ostrzak/mrna-toy/docs/images/toy-concept.prompt.txt

Use case: sketch-to-render.
Asset type: a new current-V3 concept illustration for a wearable mechanical mRNA translation toy's project documentation.
Input image: the supplied FreeCAD screenshot is the CURRENT structural reference. Transform this engineering screenshot into a polished, believable industrial-design product concept render. Preserve its component relationships; refine lighting, surface finish and presentation. This is concept art, not a manufacturing drawing.
Scene and composition: one complete unworn bracelet, three-quarter product view on a warm light-grey studio surface, soft contact shadow, landscape composition. Show the entire cuff, its opening, both ribosome lobes and the entire emerging protein strand, large and readable. No people, inset panels or extra products.
Architecture to preserve: a substantial matte navy plastic C-shaped cuff, about 60 mm internal diameter and 20 mm wide, with a continuous palmar arc and its opening close to the ribosome on the upper side, as in the screenshot. A separate much narrower teal RNA-like C dial slides in a shallow track along the cuff edge; it has small rounded mint, amber and lilac nucleotide crossbars. Make the distinction between structural cuff and thin moving RNA dial unmistakable. In this partly played pose the RNA arc can cross part of the cuff opening. Keep the structural cuff itself visibly open. The ribosome is fixed on ONE end of the cuff: organic asymmetric lavender upper and deeper-purple lower lobes, with a neat seam for the upper lobe to swivel. It does not rigidly connect the two cuff ends.
Protein: one short open chain of small simple coral/peach rounded bead placeholders on a fine concealed poseable core exits directly from one low side port beside the ribosome, roughly tangent to the RNA path. Show about 12–18 beads in one relaxed partial folded curve away from the cuff, with one free terminal end. Keep beads round, consistent in size and spacing, as in current CAD; their more molecular redesign is future work. All waiting beads are hidden INSIDE the thick cuff. No visible incoming chain, no bead loop around the wrist, no second exposed end, no tight protein turn around the swivel, no wire sticking out of the free end.
Finish and style: attractive restrained product visualization, finely satin plastic, soft studio light, realistic highlights, rounded edges, clean readable silhouette. Retain navy/teal, lavender and coral colours as provisional design colours. Avoid visual clutter and an oversized perfect circular halo.
Avoid: flexible fabric or silicone straps, buckles, elastic bands, closed solid bracelet replacing the C cuff, exposed conventional rack teeth, DNA double helices, motors, screens, jewellery chains, extra side-group beads, new fasteners or invented mechanism details. No labels, lettering, arrows, logos or watermarks.
