ostrzak/mrna-toy/docs/development.md

# Development and local handoff

## V6 updated print candidate

Select `--version 6-updated-print` for the printed-fastener and stock-spring
derivative. Its source and native model live in `cad/v6-updated-print/`;
builds and reports go to `build/v6-updated-print/`. The default remains V6.
Use the doctor/build/validate commands below with the explicit version.
The [A1 mini guide](../print/v6-updated-a1-mini/README.md) gives the
STEP/STL exporter, mesh checker and Bambu fit-plate commands. Slicing never
dispatches a print. Saved CAD/report promotion remains deliberate.

## V6 updated candidate

For grouped STEP/STL feasibility exports, see
[the print review](v6-updated-print-review.md) and run
`scripts/export_v6_updated_review.py` through FreeCAD's Python command. Check
the resulting binary STLs with `python scripts/check_stl_exports.py build/v6-updated-print-review`.
Exports stay in ignored `build/`; they are separate from the V4 Print prototype package.

Select `--version 6-updated` for the separate candidate on `version6-updated`.
It uses V6 mechanics and V7 RNA traversal, with explicit spring hardware and a
folded detent. Its self-contained source is `cad/v6-updated/`; generated
outputs go to `build/v6-updated/`. The saved model and reports are protected.
Use the same doctor/build/validate commands below with that explicit version.
`presentation_v6_updated.run(model_path, output_dir)` writes normal-reopen
evidence and actual spring/leaf inspection views before deliberate promotion.
The native spring sweeps make cap recomputes slower. CAD clearance does not
establish folded-leaf force, supplier spring selection or physical operation.

## V7 unfinished cloud continuation

The user authorized GitHub/cloud continuation. Read
[docs/v7-cloud-handoff.md](v7-cloud-handoff.md) for the branch, requirements,
runtime boundary, source roles and incomplete checks. Provision a compatible
FreeCAD runtime in the cloud, verify `Part` and bundled `fcgear` with `doctor`,
then select `--version 7` explicitly. The launcher remains on V6 by default.
The Windows GUI/MCP connection is not needed or assumed in another runtime.

The continuation exercised FreeCAD 1.1.4 in the cloud, including GUI work on a
virtual display. V7's current checkpoint is INCOMPLETE_CONTINUATION at the user's
stop; its mechanical status remains REVIEW. Its validator includes
`mechanical_v7.py`: a collision-free animation cannot pass a failed force or
partial-return necessary condition. See [the force audit](../cad/v7/engineering.md).
V7 `build()` defaults to `build/v7/`; promotion of saved CAD, reports and actual
views is deliberate. All previous version files remain preserved.

The upper skin uses ruled elliptical latitude sections with a conservative
0.067 mm deviation bound, while the lower organic body retains exact rational
patches. Check all five structural solids with extended BOP validation and
keep the explicit shell-insertion and screw-seat checks. Basic solid validity
does not replace those checks. The current trip/reset remains mechanically
unfinished even when rigid housing and assembly corrections pass.

```sh
python scripts/check_repo.py
python scripts/cad.py doctor --freecad /path/to/FreeCADCmd
python scripts/cad.py build --version 7 --force --freecad /path/to/FreeCADCmd
python scripts/cad.py validate --version 7 --freecad /path/to/FreeCADCmd
```

Do not turn the V7 REVIEW report into a PASS based on a static check,
native animation, a report from another version or missing CAD dependencies.
Keep generated files under `build/v7/`; source, saved checkpoint, real CAD
views and report boundaries should agree when intentionally updated.

## Current V6 workflow

V6 is self-contained in `cad/v6/`: geometry, the independent arc-length route
helper, validator, macro, saved model, views and report. It does not import or
modify V5. The launcher defaults to V6 and protects every saved version:

```sh
python scripts/cad.py doctor --freecad PATH
python scripts/cad.py build --version 6 --force --freecad PATH
python scripts/cad.py validate --version 6 --freecad PATH
python scripts/check_repo.py
```

Generated files go to ignored `build/v6/`. The known compatible runtime is
FreeCAD 1.1.4 with `Part` and bundled `fcgear`. This revision is exercised with
that runtime on Linux, including GUI presentation and normal reopening. No
Windows desktop or MCP connection is a repository dependency.

Before promotion, call `bracelet_v6.present(document)` in the GUI, save, close
and reopen normally. Capture `handheld.png`, `open.png`, `underside.png`,
`mechanism.png`, `cap-input.png`, `home.png`, `side.png`, `fasteners.png` and `spindle.png`
from that geometry. Run a fresh
validation against the promoted saved file and promote its report, then run
the repository checker. The version macro opens the adjacent saved model.

V6 checks saved rack/gear and bead/drum solids, continuous envelopes, captive
guide/end-stop witnesses, actual clasp fit and travel, native positions AND
orientations in both RNA modes, direct reversal at rest, cap feed and return,
cam clearance and positive stops. Flexible RNA/leaf deformation is prescribed;
spring volumes are space claims. CAD does not establish physical force,
acoustic feedback, snap retention, strain, print fits, fatigue or hand comfort.

The compact routing refinement checks actual travelling RNA cells/bases against
the whole lid and cover, including both shoulder bends and the continuous
open-tail envelope. `assembly_v6.py` checks aligned fasteners, finite seats and
wall material, local section behavior, integral roots, key torque and sampled
vertical insertion paths. A basic solid-validity flag alone is insufficient.
The GUI renderer frames exact visible solid bounds and also writes actual
`fasteners.png` and `spindle.png` sections. Source/model/report hashes and all
nine views must agree before finishing an intentional V6 update.

## Preserved V5 workflow

V5 is the handheld design in `cad/v5/`. Its source, validator, saved model,
macro, report and actual CAD views belong together. It builds from its own
source and does not import or modify V4. Select V5 explicitly:

```sh
python scripts/check_repo.py
python scripts/cad.py doctor
python scripts/cad.py build --version 5 --force
python scripts/cad.py validate --version 5
```

With the known local Windows runtime, append
`--freecad "C:\Program Files\FreeCAD 1.1\bin\freecadcmd.exe"`.
Generated files go to ignored `build/v5/`; saved version models and reports
are protected. The same launcher retains explicit `3`, `4` and `4-print` modes.

Before promoting V5, use its `present(document)` in the GUI and save display
state, then close and reopen normally. Save `handheld.png`, `mechanism.png`,
`drum.png` and `home.png` from that geometry. Run a fresh validation against the
promoted model, then the repository checker. Never substitute an AI concept
image or an old V4 report for current CAD evidence.

V5 checks real bead solids and spherical bounds through the sampled pocket
handoff, both actual involute gear meshes, native forward/reverse motion,
housing clearances and geometric stops. Click leaves are unloaded elastic
geometry; their preload overlaps are reported separately. The cap spring is a
space claim. This does not qualify clicking, RNA flex, force, fatigue or printing.

## Preserved V4 development

## Files and versions

V4 in `cad/v4/` is a preserved cuff comparison. Its [source](../cad/v4/bracelet_v4.py), [validator](../cad/v4/validation_v4.py), [model](../cad/v4/RibosomeV4.FCStd), [macro](../cad/v4/RibosomeV4.FCMacro), [report](../cad/v4/checks.json) and views belong together. V3 and V2 retain their original validation boundaries.

The V4 build revises four shapes in its own copied model: cuff front, cuff rear, RNA and upper lobe. It retains the other mechanism shapes and native expressions and does not read or write V3. `build_from_scratch()` remains available for complete procedural generation. The version macro selects its adjacent saved model.

## Runtime and commands

Python 3.10+ runs the repository checker and launcher. Geometry requires FreeCAD's own runtime with `FreeCAD`, `Part` and bundled `fcgear`; installing a normal Python package is insufficient. The known local runtime is FreeCAD 1.1.4. GUI presentation additionally uses `FreeCADGui` and its PySide bindings.

```sh
python scripts/check_repo.py
python scripts/cad.py doctor
python scripts/cad.py build --version 4
python scripts/cad.py validate --version 4
```

Select V4 explicitly. On this Windows installation:

```powershell
python scripts/cad.py build --version 4 --freecad "C:\Program Files\FreeCAD 1.1\bin\freecadcmd.exe"
```

That path is a local example, not a repository dependency. Alternatively set `FREECAD_CMD` or put `FreeCADCmd` / `freecadcmd` on PATH. In another environment provision a compatible runtime and run `doctor`. The Windows GUI and MCP connection are local conveniences, not portable dependencies. The earlier local-only decision is superseded by the V7 cloud-continuation authorization above.

## Output boundaries

- `doctor` checks runtime imports and version; it does not build geometry.
- `build` writes and checks `build/v4/RibosomeV4.FCStd` and `build/v4/checks.json`.
- `validate` opens the saved version model in memory and writes a fresh report into `build/v4/`. Use `--model build/v4/RibosomeV4.FCStd` to check a generated model.
- `--force` allows replacing generated CAD; `--output PATH` selects another output folder. The launcher refuses to overwrite saved version CAD or reports.
- `--version 3` selects V3 explicitly. Its report remains incomplete unless a separate full run establishes otherwise.

Child output is streamed for progress. A failed runtime or `REVIEW` result is not a fresh PASS. Generated outputs, caches and FreeCAD backups stay out of Git.

Before promoting a generated model, open it in the GUI, put its source folder on `sys.path`, import `bracelet_v4 as model`, call `model.present(document)`, and save its display state. Verify a normal close-and-reopen. Headless files can otherwise load with all parts hidden; the repository checker rejects missing GUI data. Compare model, report and rendered views before intentionally promoting them together.

To inspect a generated model interactively, open it directly; the version macro deliberately chooses the saved adjacent model. `model.open_controls(document)` adds controls. Do not close or overwrite unrelated unsaved GUI documents.

## Validation scope

V4 returns `FOCUSED_PASS` for its changed geometry: valid connected solids, continuous RNA/protein envelopes, cover clearance, nine actual gear phases, actual saved bead-to-feeder phase contacts, travel stops, prescribed native positions and the example hand pose. Ten coupled poses include both swivel extremes. The cover envelope conservatively bounds its complete inverse rotation range.

This does not complete V3's unfinished full validation. The copied baseline suite remains available separately in the V4 validator. No check proves friction, force, elasticity, print fits, fatigue, strength, comfort or reliable physical feeding. Wire segments are chords and the detent shape represents unloaded geometry with intentional preload.

For source edits run the repository checker. For geometry or motion edits also run appropriate CAD checks and inspect the result. If dependencies are unavailable, say so; a static check or old report is not a CAD run. A1 mini prototype preparation is now authorized in the separate V4 Print derivative.

## A1 mini derivative

Use `python scripts/cad.py build --version 4-print --force` or `validate --version 4-print`. Outputs go to `build/v4-print/`. Source is `cad/v4-print/bracelet_v4_print.py`. Run `export_print.main()` in FreeCAD after adding that folder to `sys.path` to export the generated CAD. `python scripts/print_package.py profiles`, `author`, and `slice` generate the offline plate package, using installed Bambu Studio resources. Review mesh warnings and slicer checks before printing. Do not promote an unfinished export check to a physical PASS.
