ostrzak/mrna-toy/docs/status.md

# Project status and next decisions

## V6 updated print candidate — 2026-11-06

The user authorized manufacturing changes with as few bought components as
possible and standard stock springs only. The separate
[print candidate](../cad/v6-updated-print/README.md) contains printed coarse
housing screws, replaceable keyed nuts, a low stopped spindle cap and
integral spring supports. Two selected TECH-AR Allegro torsion springs
replace the illustrative spring pair. The prior models remain preserved.

The native GUI model has been reopened and its saved motion tested without
the generator sources. CAD status is **FOCUSED_PASS**: a complete sweep plus
a focused 0.3 mm cup-wall trim follow-up, with 332 other local shapes and all
native expressions unchanged within numerical serialization precision.
The follow-up proves material-only removal, retained roots and clear spring
contacts; zero unintended collisions remain reported. Its report retains
the complete prior sweep and the correction's evidence separately.

All 20 grouped model-part/coupon STEP/STL exports passed their checks and
the independent mesh audit. Bambu Studio sliced the nine PETG fit-test
objects for A1 mini / 0.4 mm using the exact PETG Translucent preset. The
[A1 mini guide](../print/v6-updated-a1-mini/README.md) records the stock BOM,
fit trials and remaining physical tests. RNA remains a nominal-layout
reference, and the package is not a complete sliced toy. Mechanical status
remains REVIEW; no physical print or operation is claimed.

## V6 updated candidate — 2026-11-04

The user authorized a separate `version6-updated` branch from `version7` and
confirmed V6 mechanics with V7 RNA traversal. Source and evidence live in
[cad/v6-updated](../cad/v6-updated/README.md). V6, V7 and earlier versions remain
preserved. The launcher default remains V6.

This candidate adds the 13.2° far-flank route and associated housing changes,
native metal coil solids with terminal/seat geometry, a fixed torsion cup,
and a single connected serpentine detent. Read its own report for CAD results.
FreeCAD 1.1.4 completed the focused sweep and targeted washer, pedestal and
terminal-window corrections. The saved report is **FOCUSED_PASS** for CAD,
with zero remaining reported collisions, native GUI reopening and a 296-feature
presentation/audit comparison. Mechanical status remains **REVIEW**.
The old straight-leaf force calculation does not apply to the new folded
part. Spring hardware fabrication, installation under preload, folded-leaf
holding force, return under friction, printing and physical tests remain open.

## V7 cloud CAD review — 2026-11-03

V7 is an unfinished candidate on `codex/v7-forward-pickup`, copied separately
from V6 at the user's authorization. It adds two opposing drive/pickup tracks,
a lift fork and latch, nominal trip leaf/reset roof, detachable upper shell
and carrier, and a shallower RNA route around the far flank. The dedicated
click leaf is retained. V6 and older CAD/report/image bytes are preserved.

Cloud FreeCAD 1.1.4 with Part and bundled fcgear passed doctor. The continuation
corrects obstructed carrier/fork bores, manual-pawl crossover interference and
the detent's installation path. Its 13.2-degree RNA route is higher on the far
flank, with a narrower groove and preserved cavity wall.

The follow-up verified GitHub checkpoint `5c4b2c0`, then repaired the tangent
keeper pocket, rear lid column, lifted manual-pawl clearance, shell screw axes
and seats, and downward shell access. The upper organic skin uses ruled
elliptical sections with a conservative 0.067 mm surface-deviation bound;
the anchor-access sector avoids the rectangular pocket's Boolean defect.
The saved coupling retains its 3° manual entry and prescribed trip/reset.

The user paused work and requested a GitHub checkpoint during the RNA-forward
coupling sweep. The saved report is **INCOMPLETE_CONTINUATION**; mechanical status
remains **REVIEW**. Structural BOP, source regeneration and GUI acceptance passed,
but the integrated audit and mechanical finish are incomplete. The previous
completed independent mechanical audit rejects the
current return-force budget and partial-return constraint. Trip snap and
continuous-pull reset remain unresolved; the GUI pause is not a mechanical
gate. No functional or physical PASS is claimed. Read
[the continuation record](v7-cloud-handoff.md), [V7 guide](../cad/v7/README.md),
[mechanical audit](../cad/v7/engineering.md) and [report](../cad/v7/checks.json).
The launcher still defaults to V6; select V7 explicitly.

## V6 captive open/closed RNA — 2026-10-31

The user authorized a separate V6 after choosing open-strand play with an
optional joined underside loop. V5 and all earlier CAD/print files are
preserved. The latest contract removes the user-operated reverse release:
backward RNA directly retracts the protein through the same drum. The clasp
halves also act as end stops; captured ports keep either open end from leaving
the setup. The underside return remains external and open, without a parking
clip.

The current in-place refinement removes both outer RNA holders. A short central
capture channel retains the strand; broad curves cross the lower flank before
passing under the flatter dome through an open groove. Its 226.195 mm nominal
material length retains the full 149.288 mm travel. Exact loop shape is secondary
to handling and compact guidance. The side-route adjustment lengthens the strip
by 22.619 mm and keeps the drive entry, fastening, mechanism and clasp geometry.

The [assembly audit](v6-assembly.md) found obstructed housing-screw passages,
a floating spindle and an unsupported washer seat in the preceding V6.
The current design has one aligned three-screw stack, an analytic load-bearing
lid plate, an integral spindle root and a separate seated cap washer. Two keyed
rotor parts permit the lid and cover to be inserted. Checks include real shaft
passages, finite bearing seats, local material sections, integral roots,
key torque blocking and sampled insertion poses, in addition to motion.

V6 replaces the large RNA ring/idler with a straight rack and one shared
84-tooth gear. It retains the 28-pocket bead drum and 22-step / 132 mm protein
feed with four hidden beads. A separate symmetric detent permits bidirectional
clicking. The upper input has an internal cam-lifted pawl, disengaged at rest.
The clasp travels across the underside and stays outside the drive ports.

Consult the [V6 guide](../cad/v6/README.md), [current model](../cad/v6/RibosomeV6.FCStd),
[open mode](../cad/v6/open.png), [underside return](../cad/v6/underside.png)
and [focused report](../cad/v6/checks.json) for the actual result and boundary.
RNA/leaf deformations are nominal prescribed poses and the two input springs
are space claims. TPU behavior, clasp retention, click sound and force,
cap engagement/return under load, overload resistance, hand fit, manufacturing
and reliable physical feeding remain unqualified.

## Preserved V5 proportions and clearance review — 2026-10-30

The upper shell now has a fuller asymmetric head/body/platform silhouette,
guided by RCSB ribosome references. A fixed underside palm swell gives the
supporting hand a surface below the moving RNA plane. The drive architecture
and native motion are retained. Local lid, keeper, axle, cap support and yoke
clearance corrections address clashes omitted by the earlier focused suite.
The expanded checks include nine rocker positions at three release heights.
See the [review and references](v5-proportions.md),
[current CAD](../cad/v5/handheld.png), [grip side view](../cad/v5/grip.png)
and [report](../cad/v5/checks.json). Physical hand fit remains untested.

The user is reconsidering whether the RNA should form a complete loop. It is
retained here to avoid changing the mechanism during the proportion pass;
the final RNA route is not settled.

## V5 handheld redesign — 2026-10-29

The user authorized V5 after choosing a handheld ribosome and a closed RNA loop.
V5 is a separate design in `cad/v5/`; V4 and all previous CAD/print files are
preserved. The single-row drum directly carries returning beads in pockets,
without a cord reel or tensioned spring take-up. The lower body is larger; the
upper body is a smaller rocking input.

The source, native motion, focused geometric checks and desktop presentation
are being built together. Consult [V5 checks](../cad/v5/checks.json) for the exact
result rather than reusing a V4 PASS. No V5 physical or slicer qualification is
claimed. The upper-return spring is a space claim; ratchet leaf behaviour,
reverse release, flexible RNA retention, bead fixation, fatigue and printed
assembly remain open. See the [V5 guide](../cad/v5/README.md).

The older status below is retained for the cuff comparisons.

## A1 mini derivative - 2026-10-29

The user authorized manufacturing preparation. [V4 Print](../cad/v4-print/README.md) is separate from V4, with TPU beads, candidate 0.6 mm bores and 0.25 mm copper wire; bore samples span 0.4-0.8 mm. The package includes oriented STL parts, fit and feeder fixtures, proposed M2 hardware and assembly instructions. Focused CAD checks passed. Export/slicer qualification is being saved at the user's request before all checks finish; consult [handoff status](../print/v4-a1-mini/handoff.json). No physical printing or assembly is demonstrated.

Updated 2026-10-28. **V4 is the current working CAD**, copied from V3 at the user's request. V3 files are preserved as the preceding comparison; V2 retains its invalidated historical-validation warning. No physical prototype results are recorded.

## V4 changes

- A rounded fixed front cover and curved upper pinion guard conceal the front mechanism. The upper lobe is cleared around a conservative full-swivel envelope.
- The cuff edge is recessed beside the RNA. Retaining ledges and a recessed outer shield preserve guidance while hiding the gear rail.
- One rounded RNA backbone carries 128 free-ended rounded bases. Their nominal tips project 4.5–5.64 mm ahead of the recessed cuff face. This is geometric finger access, not a usability test.
- Protein beads, their pitch, the storage path and outlet, common drive shaft, click/swivel coupling, three bases per bead, bounded travel and the engaged hidden tail are retained. Protein shaping remains manual.

See the [V4 guide](../cad/v4/README.md), [current view](../cad/v4/bracelet.png), [RNA detail](../cad/v4/rna.png) and [covered mechanism](../cad/v4/mechanism.png). The older AI illustration predates these changes; it is not a geometry reference.

## Check boundary

The local FreeCAD 1.1.4 V4 build passed focused checks for the four revised connected solids, RNA/protein envelopes, nine actual gear phases, ten coupled poses, actual saved bead-to-feeder contacts, native position expressions, travel stops and the illustrative hand-shaped strand. The report labels this **FOCUSED_PASS** and keeps V3's full baseline validation **INCOMPLETE_USER_STOPPED**.

The saved model must include desktop visibility and colours and be checked by normal GUI close-and-reopen. Its report and views are promoted together. The repository checker checks source syntax, links, CAD containers and report boundaries; it does not prove physical operation.

## Physical and manufacturing work still open

V4 remains an engineering prototype, not a dependable print-and-assemble release. A1 mini prototype preparation is now authorized in the separate V4 Print derivative.

| Area | Unresolved work |
| --- | --- |
| RNA and cuff | Finger purchase, turning force, retention, spread force/strain at home, fatigue and comfort. |
| Protein feed | Bead fixation at pitch, forward/reverse handoff, wire buckling, friction and end retention. |
| Wire and beads | Bore finish, pose retention, repeated-bend fatigue and assembly/replacement method. |
| Mechanism | Printed gears, approximately 0.12 mm nominal pocket clearance, cam/slider fits, torque, wear and the 0.45 mm click leaf. |
| Manufacturing | Printer/process, materials, calibrated fits, wall thicknesses, support access, print orientations and final fasteners. |

A short feeder-and-channel bench assembly with representative beads and wire remains a useful proposed next engineering step. A short feeder fixture is now included in the V4 Print package; no physical tests have been run. Full wearable reliability will require physical testing.

## Preserved comparisons

**V3:** compact lobed beads and a shallow same-direction protein exit. The user stopped full validation and accepted an immediate save; its report remains incomplete. Its 2026-10-28 desktop repair restored visibility without changing geometry or native motion expressions. V4 is a separate copy.

**V2:** opposite-direction feed comparison. A later audit found about 7.167 mm³ bead-to-wheel interference at home that its profile-only check missed. Keep `HISTORICAL_PASS_INVALIDATED`; it is not a validated baseline.

The earlier local-only decision is superseded by the V7 cloud-continuation authorization above. Superseded experiments belong in Git history, not new archive folders.
