ostrzak/mrna-toy/cad/v6/inspection/README.md

# V6 — six static inspection views

Actual FreeCAD renders of the saved V6 model, at 2048 × 1536 pixels.
All six use orthographic projection, one common scale, closed RNA, 11 bead
steps and a resting upper input. The model is opened read-only for rendering;
its saved geometry and motion are unchanged.

[Front](front.png) · [Rear](rear.png) · [Left](left.png) ·
[Right](right.png) · [Top](top.png) · [Underside](underside.png)

[Download all six PNGs](V6-six-views.zip) ·
[Model](../RibosomeV6.FCStd) · [Render metadata](manifest.json)

The manifest records the source model hash, pose, common camera height and
FreeCAD runtime. These views show nominal CAD geometry, not physical tests.
