ostrzak/mrna-toy/cad/v6-updated/mechanism.png

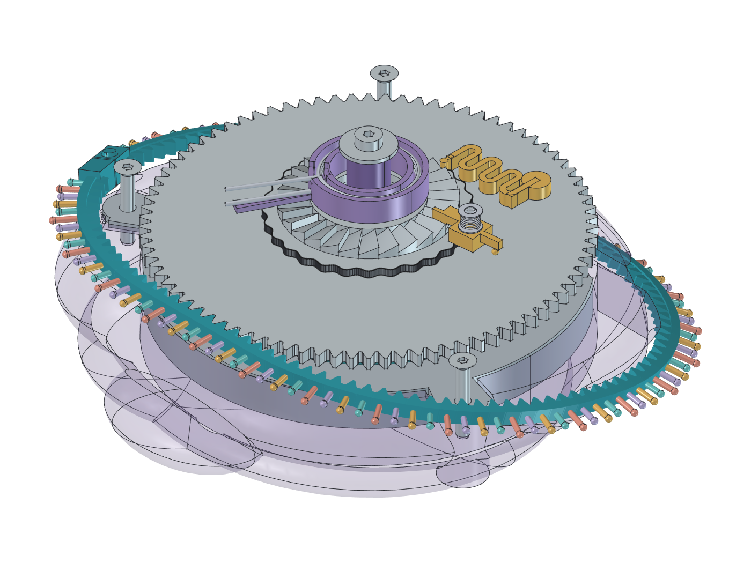
cad/v6-updated/mechanism.png
