ostrzak/mrna-toy/cad/v6-updated/open.png

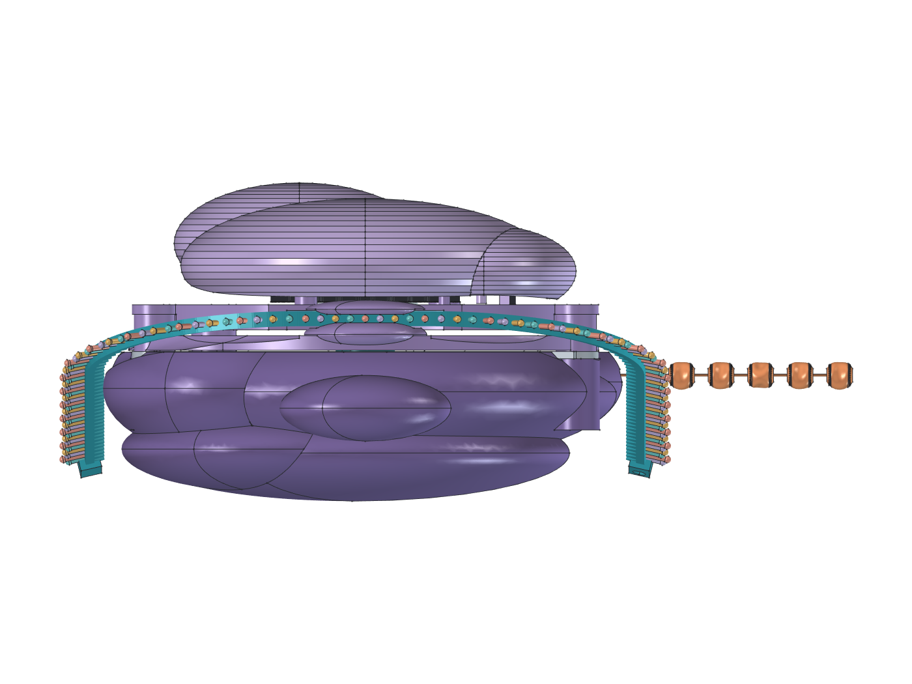
cad/v6-updated/open.png
