ostrzak/mrna-toy/cad/v6-updated/serpentine-leaf.png

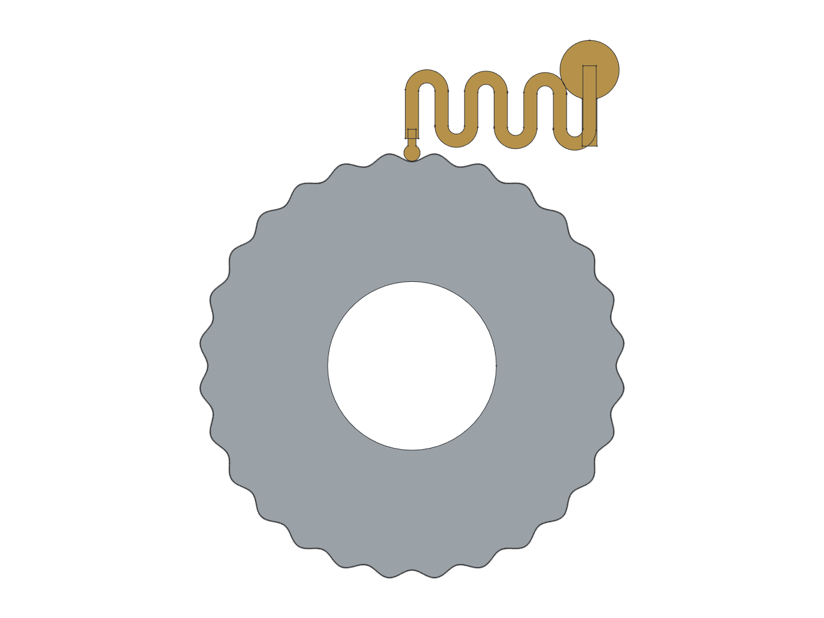
cad/v6-updated/serpentine-leaf.png
