ostrzak/mrna-toy/cad/v6-updated/side.png

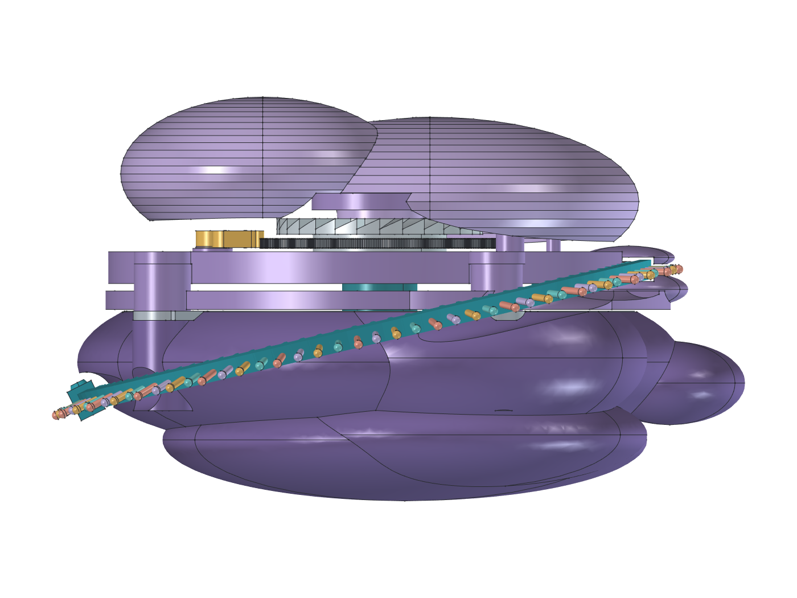
cad/v6-updated/side.png
