ostrzak/mrna-toy/cad/v6-updated/spring-loaded.png

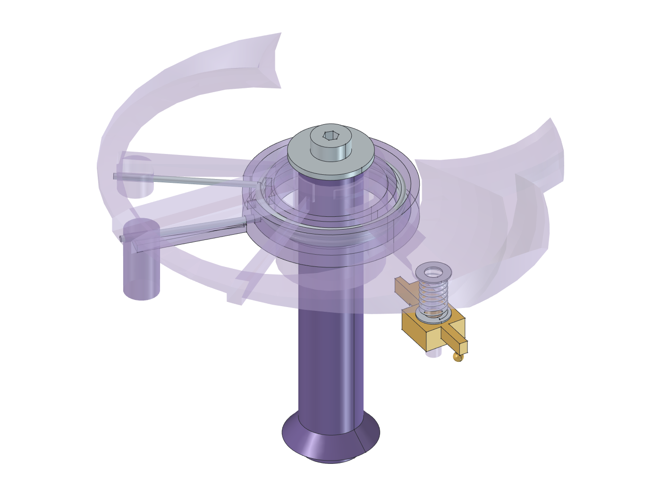
cad/v6-updated/spring-loaded.png
