ostrzak/mrna-toy/cad/v6-updated/torsion-spring.png

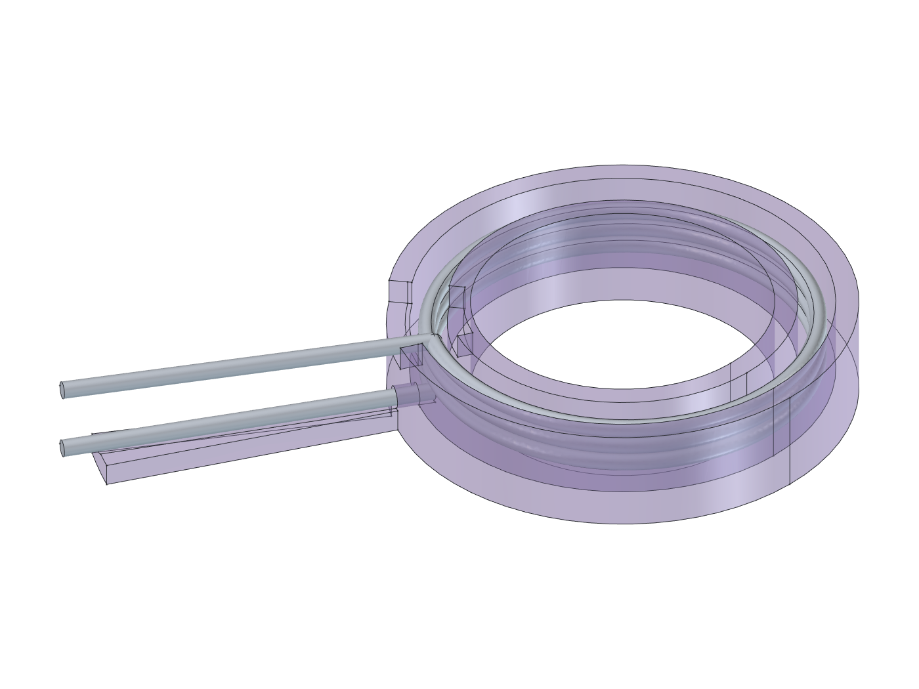
cad/v6-updated/torsion-spring.png
