ostrzak/mrna-toy/cad/v6-updated/underside.png

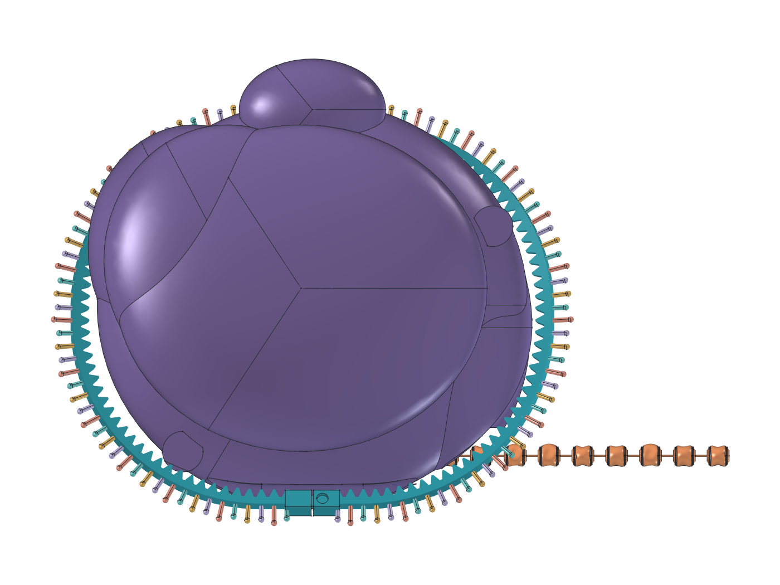
cad/v6-updated/underside.png
