ostrzak/mrna-toy/cad/v7/mechanism.png

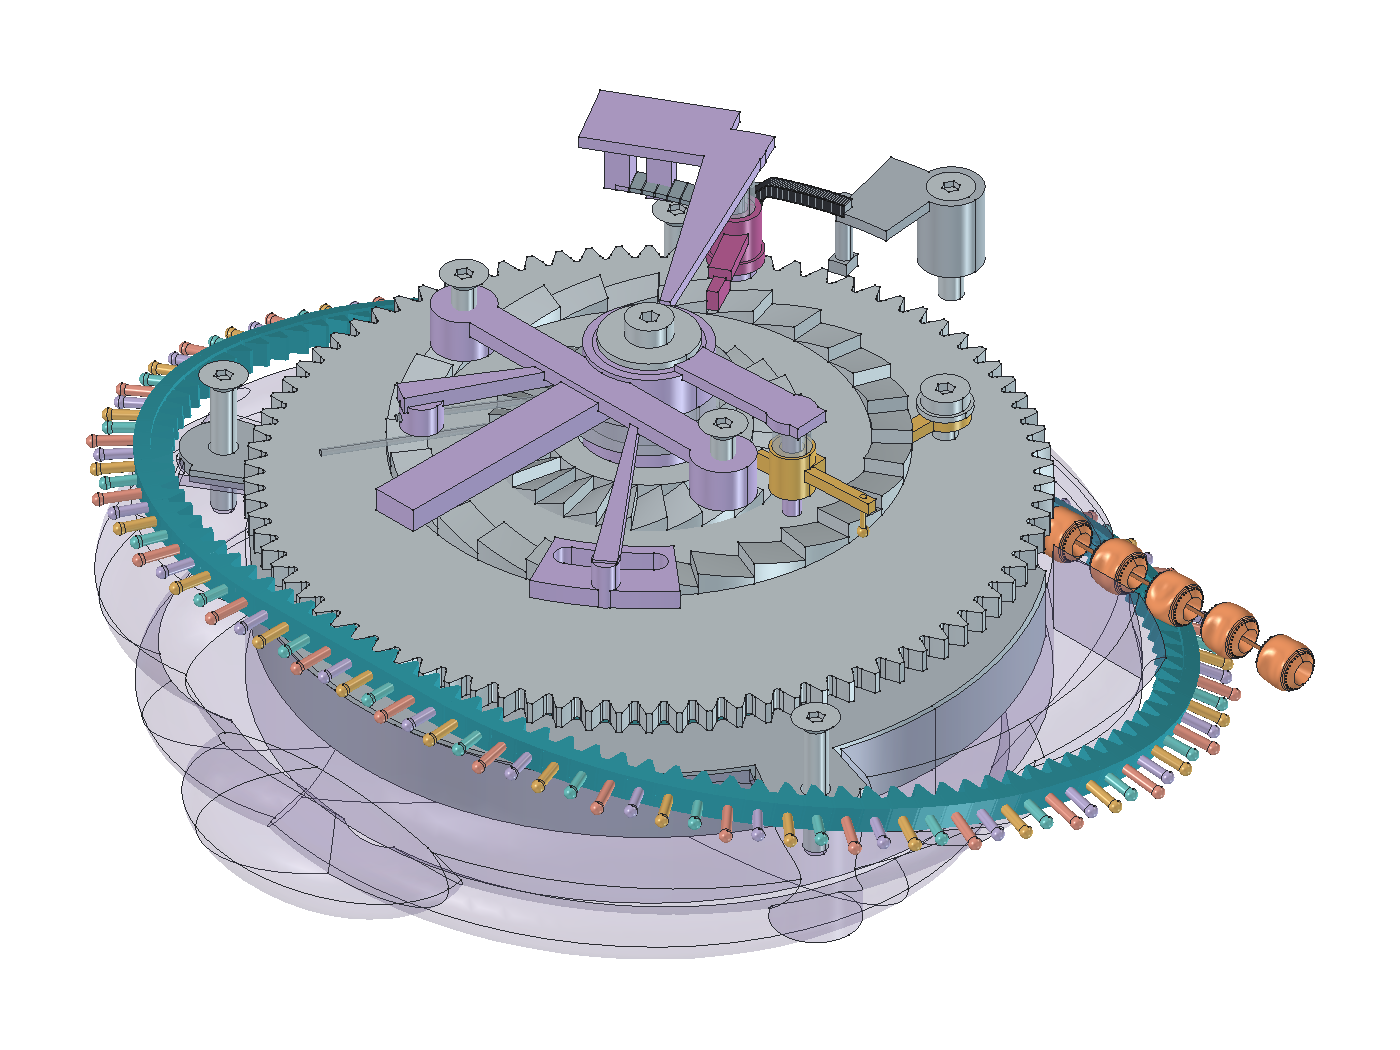
cad/v7/mechanism.png
