ostrzak/mrna-toy/cad/v7/open.png

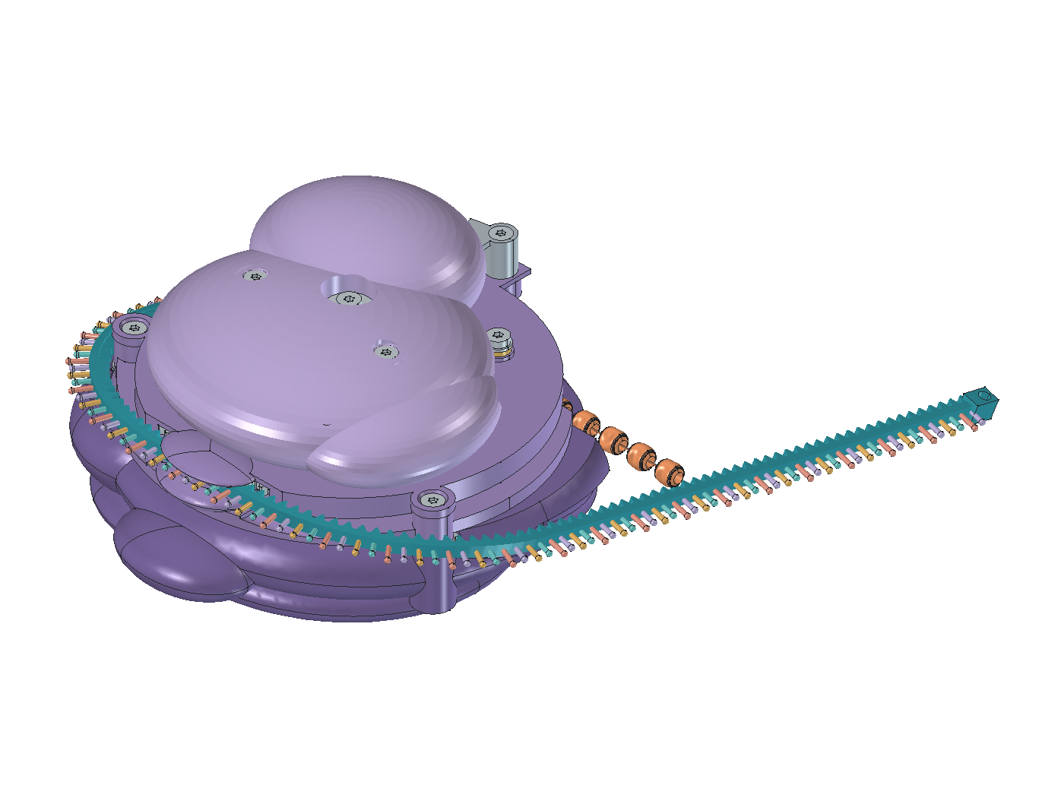
cad/v7/open.png
