ostrzak/mrna-toy/cad/v7/pickup.png

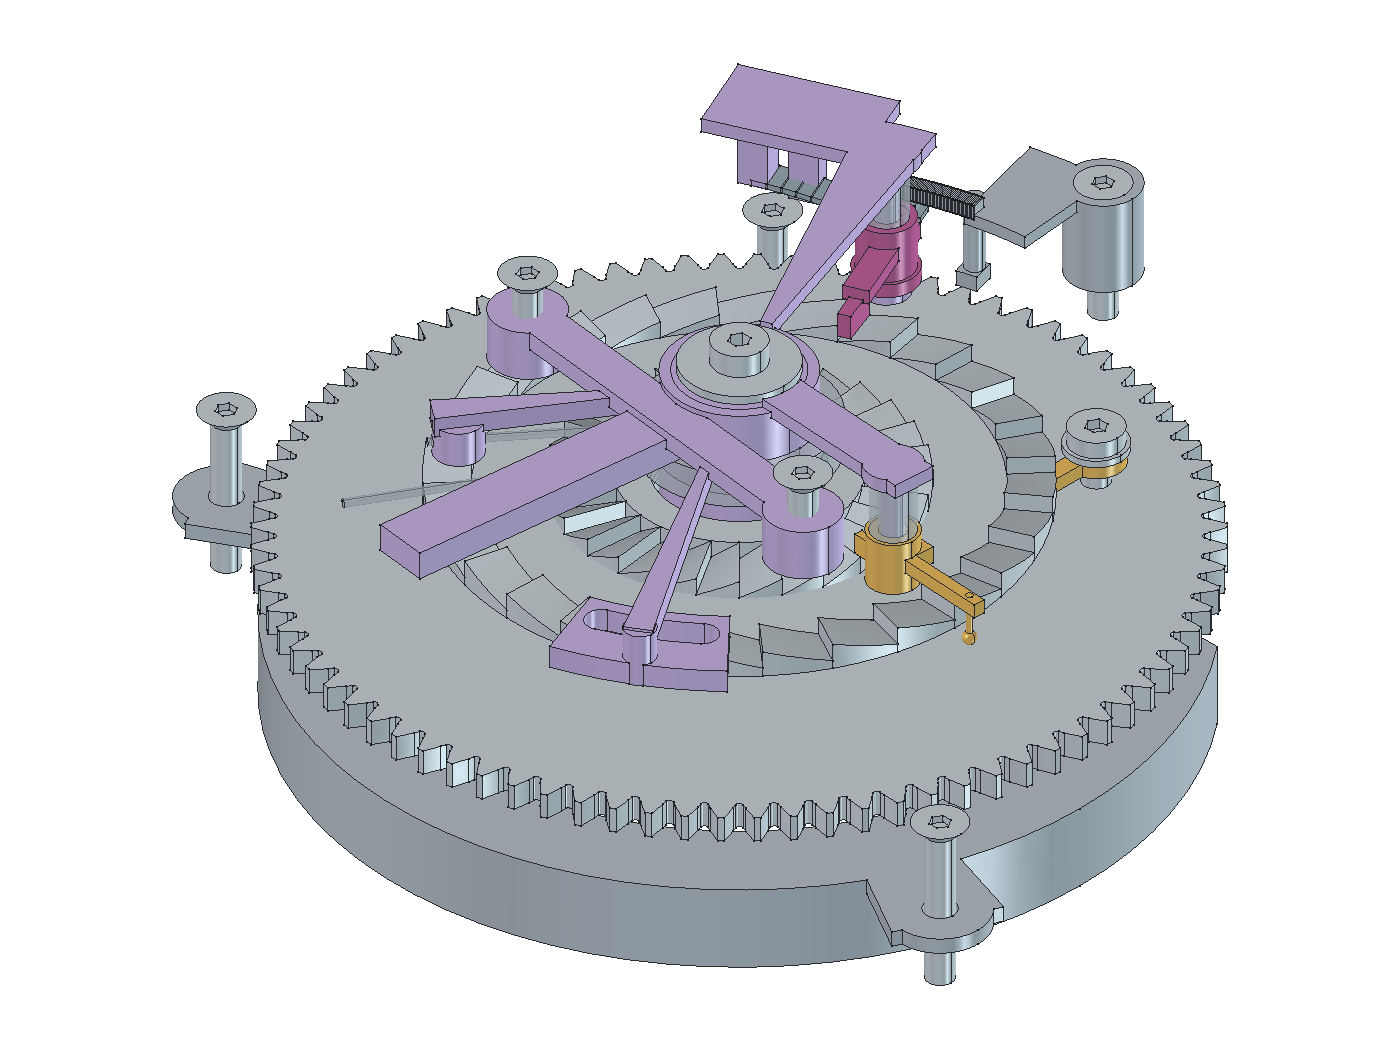
cad/v7/pickup.png
