ostrzak/mrna-toy/cad/v7/underside.png

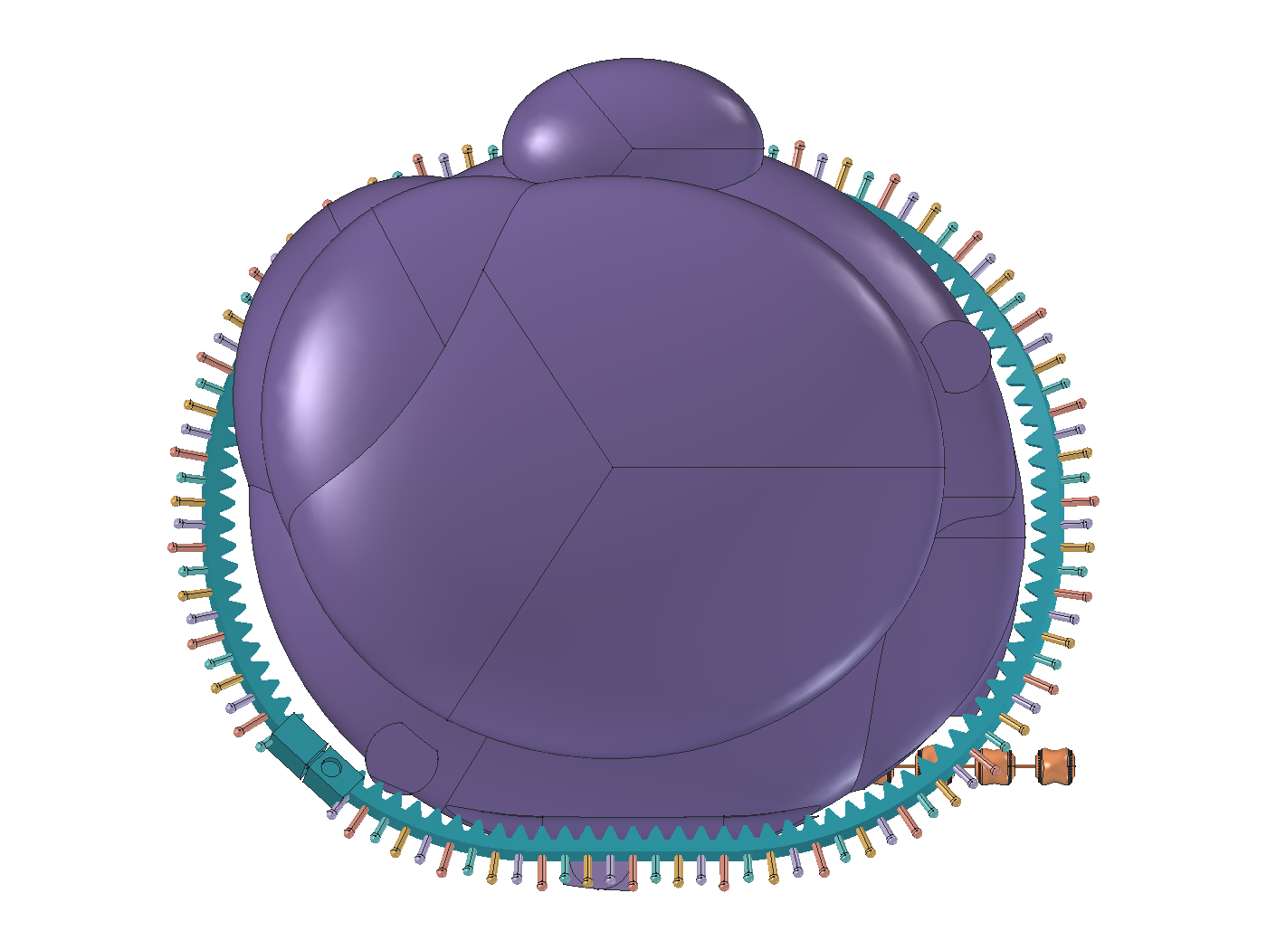
cad/v7/underside.png
