ostrzak/mrna-toy/docs/images/toy-concept.png

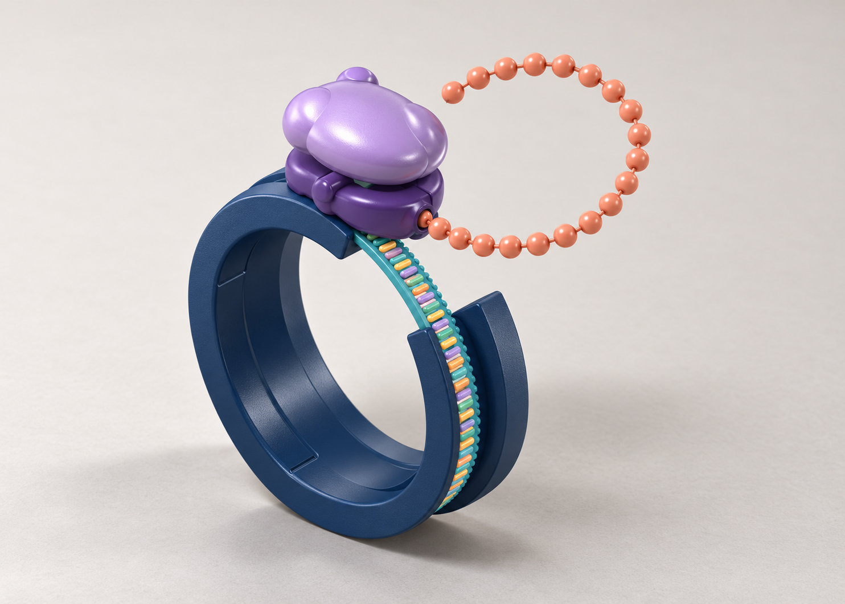
docs/images/toy-concept.png
