ostrzak/mrna-toy/docs/images/v6-updated-flexure-reference.png

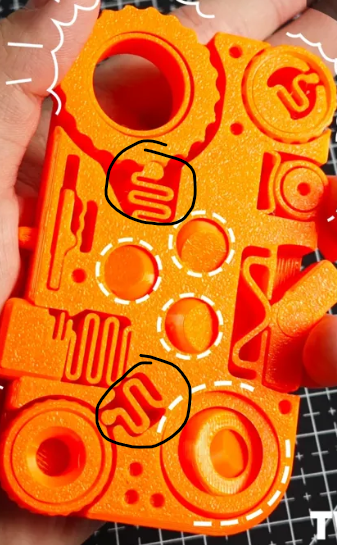
docs/images/v6-updated-flexure-reference.png
