ostrzak/mrna-toy/docs/images/v7-coupling-concept.png

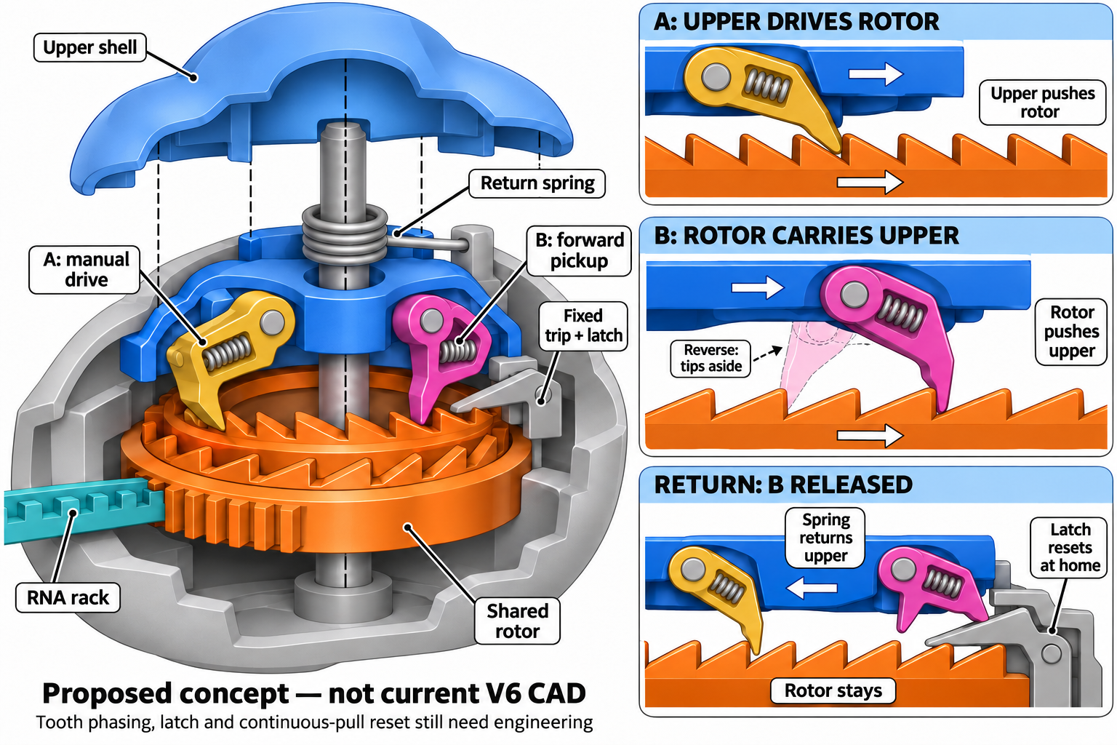
docs/images/v7-coupling-concept.png
