ostrzak/mrna-toy/docs/images/v7-routing-request.png

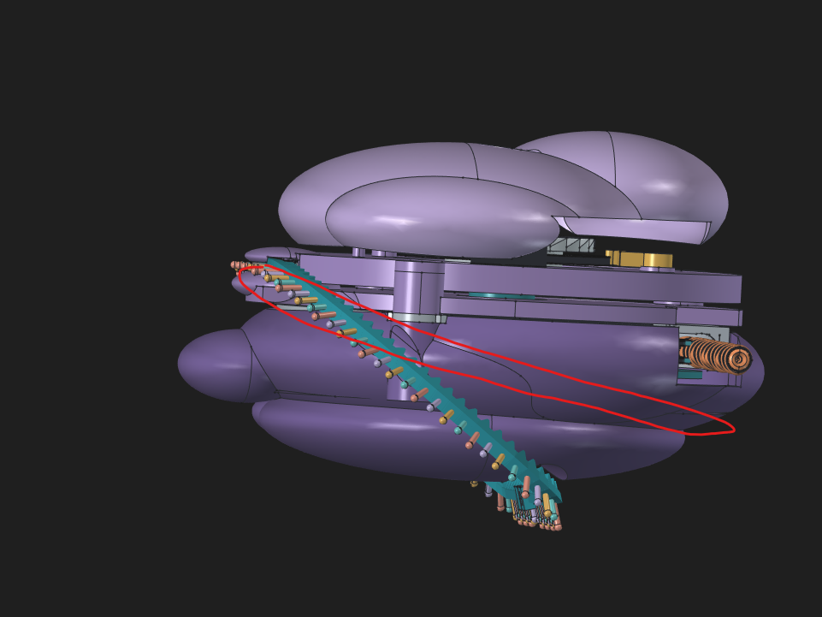
docs/images/v7-routing-request.png
