ostrzak/mrna-toy/cad/v4-print/RibosomeV4Print.FCStd

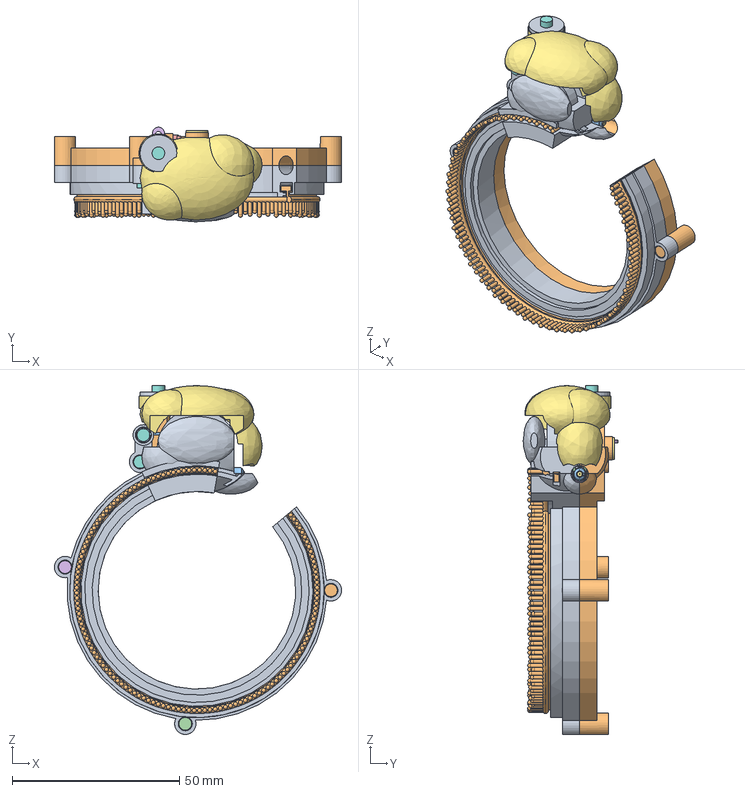
[picture p23: CAD file, 2026-10-30]
cad/v4-print/RibosomeV4Print.FCStd
85.8 x 28.3 x 104.2 mm
Recessed RNA-side cuff + fixed organic mechanism cover
Rear cuff half + keeper lid — remove to load
PETG 0.8 mm replaceable leaf — force untested
Common stationary Ø2 mm axle
Captured cam pin + guided slider + lever pin
Metal travel stop — 1 x 5.4 mm
TPU axle retention plug
M2 x 6 leaf clamp
M2 leaf clamp nut
M2 x 10 case screw
M2 case nut
M2 x 10 case screw001
M2 case nut001
M2 x 10 case screw002
M2 case nut002
M2 x 10 case screw003
M2 case nut003
RNA strand — 128 projecting bases + concealed drive rail
24-tooth RNA pinion + keyed drive shaft
8-pocket forked bead feeder — wire-clear mid-plane
8-cycle closed-groove swivel cam
Radial slotted lever + vertical swivel post + square key
Organic upper lobe — swivels about outward wrist axis
M2 x 8 swivel retainer screw
PLA retainer cap
M2 nut in accessible key pocket
TPU bead 01 — 0.6 mm central bore / recessed stops
TPU bead 02 — 0.6 mm central bore / recessed stops
TPU bead 03 — 0.6 mm central bore / recessed stops
TPU bead 04 — 0.6 mm central bore / recessed stops
TPU bead 05 — 0.6 mm central bore / recessed stops
TPU bead 06 — 0.6 mm central bore / recessed stops
TPU bead 07 — 0.6 mm central bore / recessed stops
TPU bead 08 — 0.6 mm central bore / recessed stops
TPU bead 09 — 0.6 mm central bore / recessed stops
TPU bead 10 — 0.6 mm central bore / recessed stops
TPU bead 11 — 0.6 mm central bore / recessed stops
TPU bead 12 — 0.6 mm central bore / recessed stops
TPU bead 13 — 0.6 mm central bore / recessed stops
TPU bead 14 — 0.6 mm central bore / recessed stops
TPU bead 15 — 0.6 mm central bore / recessed stops
TPU bead 16 — 0.6 mm central bore / recessed stops
TPU bead 17 — 0.6 mm central bore / recessed stops
TPU bead 18 — 0.6 mm central bore / recessed stops
TPU bead 19 — 0.6 mm central bore / recessed stops
TPU bead 20 — 0.6 mm central bore / recessed stops
TPU bead 21 — 0.6 mm central bore / recessed stops
TPU bead 22 — 0.6 mm central bore / recessed stops
TPU bead 23 — 0.6 mm central bore / recessed stops
TPU bead 24 — 0.6 mm central bore / recessed stops
TPU bead 25 — 0.6 mm central bore / recessed stops
TPU bead 26 — 0.6 mm central bore / recessed stops
Copper-core segment (nominal Ø0.36 mm)
Copper-core segment (nominal Ø0.36 mm)001
Copper-core segment (nominal Ø0.36 mm)002
Copper-core segment (nominal Ø0.36 mm)003
Copper-core segment (nominal Ø0.36 mm)004
Copper-core segment (nominal Ø0.36 mm)005
Copper-core segment (nominal Ø0.36 mm)006
Copper-core segment (nominal Ø0.36 mm)007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
