ostrzak/mrna-toy/cad/v6-updated-print/RibosomeV6UpdatedPrint.FCStd

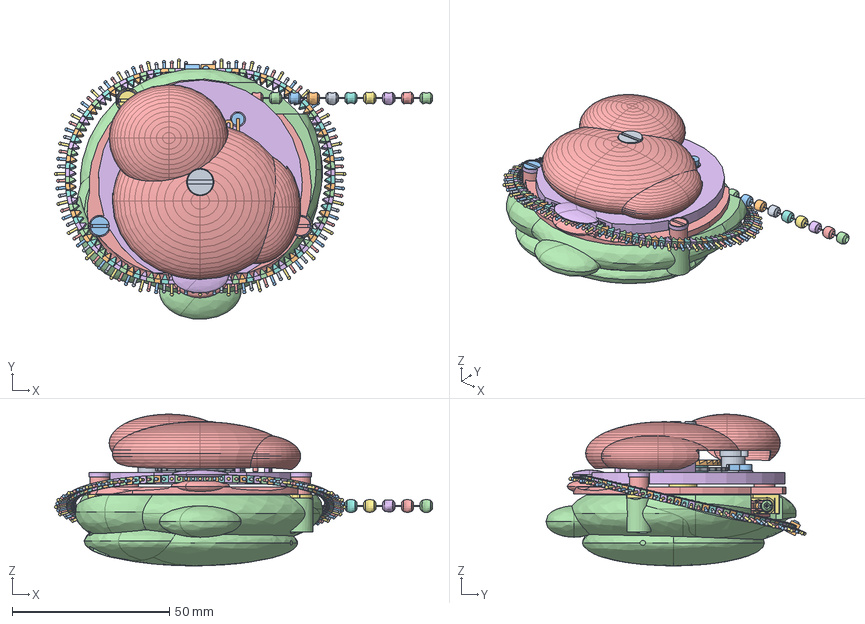
[picture p24: CAD file, 2026-11-11]
cad/v6-updated-print/RibosomeV6UpdatedPrint.FCStd
120.4 x 82.8 x 48.3 mm
Symmetric click follower — nominal flexed pose
One-piece serpentine detent: seven webs, six rounded folds
Fixed root of the one-piece serpentine detent
Flattened palm dome — shallow open RNA return groove
Lower shell lid and gear-cover mounts
Covered drive, short central RNA throat and fixed lift cam
Fixed bead keeper and tangent transfer roof
Integral smooth spindle and coarse threaded extension
Printed closed spindle cap — positive internal shoulder stop
Integral printed retaining flange — fuse with spindle cap, 0.25 mm endplay
Printed 4 mm coarse screw — 1.2 mm pitch, recessed slotted head
Replaceable printed keyed nut — load through underside access
Printed 4 mm coarse screw — 1.2 mm pitch, recessed slotted head001
Replaceable printed keyed nut — load through underside access001
Printed 4 mm coarse screw — 1.2 mm pitch, recessed slotted head002
Replaceable printed keyed nut — load through underside access002
Integral stock return-spring cup, split mandrel and stator socket
Stock MS/095P TYP2 — right-hand cap return, 23 degree proposed preload
Trimmed fixed return leg — reacts into cup socket
Return spring moving leg — tangent sliding contact on upper peg
Direct 28-pocket storage drum — tangent-relieved forks
84-tooth RNA rack gear — three bases per bead
Lower rotor D-key spindle and thrust flange — lid installs before upper rotor
Concentric input carrier outside the cap bearing
28 symmetric rounded click notches — reversible
Upper-input-only drive faces — idle input lifts clear
Positive shared drum travel-stop pin
TPU backbone cell 002 + drive tooth
Free-ended RNA base 002
TPU backbone cell 003 + drive tooth
Free-ended RNA base 003
TPU backbone cell 004 + drive tooth
Free-ended RNA base 004
TPU backbone cell 005 + drive tooth
Free-ended RNA base 005
TPU backbone cell 006 + drive tooth
Free-ended RNA base 006
TPU backbone cell 007 + drive tooth
Free-ended RNA base 007
TPU backbone cell 008 + drive tooth
Free-ended RNA base 008
TPU backbone cell 009 + drive tooth
Free-ended RNA base 009
TPU backbone cell 010 + drive tooth
Free-ended RNA base 010
TPU backbone cell 011 + drive tooth
Free-ended RNA base 011
TPU backbone cell 012 + drive tooth
Free-ended RNA base 012
TPU backbone cell 013 + drive tooth
Free-ended RNA base 013
TPU backbone cell 014 + drive tooth
Free-ended RNA base 014
TPU backbone cell 015 + drive tooth
Free-ended RNA base 015
TPU backbone cell 016 + drive tooth
Free-ended RNA base 016
TPU backbone cell 017 + drive tooth
Free-ended RNA base 017
TPU backbone cell 018 + drive tooth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
