ostrzak/mrna-toy/cad/v7/RibosomeV7.FCStd

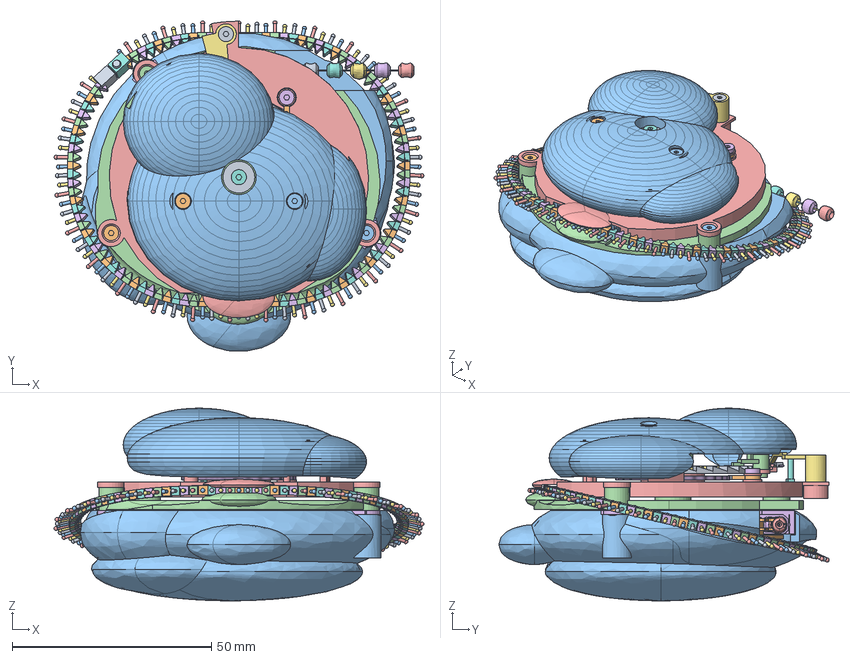
[picture p26: CAD file, 2026-11-03]
cad/v7/RibosomeV7.FCStd
92.7 x 82.8 x 48.3 mm
Symmetric click follower Ă˘â‚¬â€ť nominal flexed pose
Prescribed flexible leaf chord Ă˘â‚¬â€ť force/fatigue unqualified
Prescribed flexible leaf chord Ă˘â‚¬â€ť force/fatigue unqualified001
Prescribed flexible leaf chord Ă˘â‚¬â€ť force/fatigue unqualified002
Prescribed flexible leaf chord Ă˘â‚¬â€ť force/fatigue unqualified003
Prescribed flexible leaf chord Ă˘â‚¬â€ť force/fatigue unqualified004
Prescribed flexible leaf chord Ă˘â‚¬â€ť force/fatigue unqualified005
Prescribed flexible leaf chord Ă˘â‚¬â€ť force/fatigue unqualified006
Prescribed flexible leaf chord Ă˘â‚¬â€ť force/fatigue unqualified007
Separate bidirectional leaf root: insert radially below pickup track, then fasten
Flattened palm dome Ă˘â‚¬â€ť shallow open RNA return groove
Lower shell lid and gear-cover mounts
Covered drive, short central RNA throat and fixed lift cam
Fixed bead keeper and tangent transfer roof
Integral lower-body spindle with flared root and fixed washer shoulder
M2 x 4 cap screw Ă˘â‚¬â€ť nominal thread envelope and hex socket
Cap retaining washer Ă˘â‚¬â€ť seated on fixed spindle, 0.15 mm rocker endplay
M2 x 12 countersunk housing screw Ă˘â‚¬â€ť nominal thread envelope
M2 x 12 countersunk housing screw Ă˘â‚¬â€ť nominal thread envelope001
M2 x 12 countersunk housing screw Ă˘â‚¬â€ť nominal thread envelope002
Detent root washer: retains a standard M2 x 3 screw above the drive gear
M2 x 3 pan head: separate click leaf service fastener, nominal thread envelope
Fixed roof lowers the pickup fork on approach to home
Fixed end-of-stroke trigger post — trip snap study
M2 x 10 countersunk — removable pickup reset bridge
Direct 28-pocket storage drum Ă˘â‚¬â€ť tangent-relieved forks
84-tooth RNA rack gear Ă˘â‚¬â€ť three bases per bead
Lower rotor D-key spindle and thrust flange Ă˘â‚¬â€ť lid installs before upper rotor
Concentric input carrier outside the cap bearing
28 symmetric rounded click notches Ă˘â‚¬â€ť reversible
Upper-input-only drive faces Ă˘â‚¬â€ť idle input lifts clear
Positive shared drum travel-stop pin
B: reverse-facing 28-tooth forward-pickup track
TPU backbone cell 002 + drive tooth
Free-ended RNA base 002
TPU backbone cell 003 + drive tooth
Free-ended RNA base 003
TPU backbone cell 004 + drive tooth
Free-ended RNA base 004
TPU backbone cell 005 + drive tooth
Free-ended RNA base 005
TPU backbone cell 006 + drive tooth
Free-ended RNA base 006
TPU backbone cell 007 + drive tooth
Free-ended RNA base 007
TPU backbone cell 008 + drive tooth
Free-ended RNA base 008
TPU backbone cell 009 + drive tooth
Free-ended RNA base 009
TPU backbone cell 010 + drive tooth
Free-ended RNA base 010
TPU backbone cell 011 + drive tooth
Free-ended RNA base 011
TPU backbone cell 012 + drive tooth
Free-ended RNA base 012
TPU backbone cell 013 + drive tooth
Free-ended RNA base 013
TPU backbone cell 014 + drive tooth
Free-ended RNA base 014
TPU backbone cell 015 + drive tooth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
