ostrzak/mrna-toy/cad/v2/Ribosome.FCStd

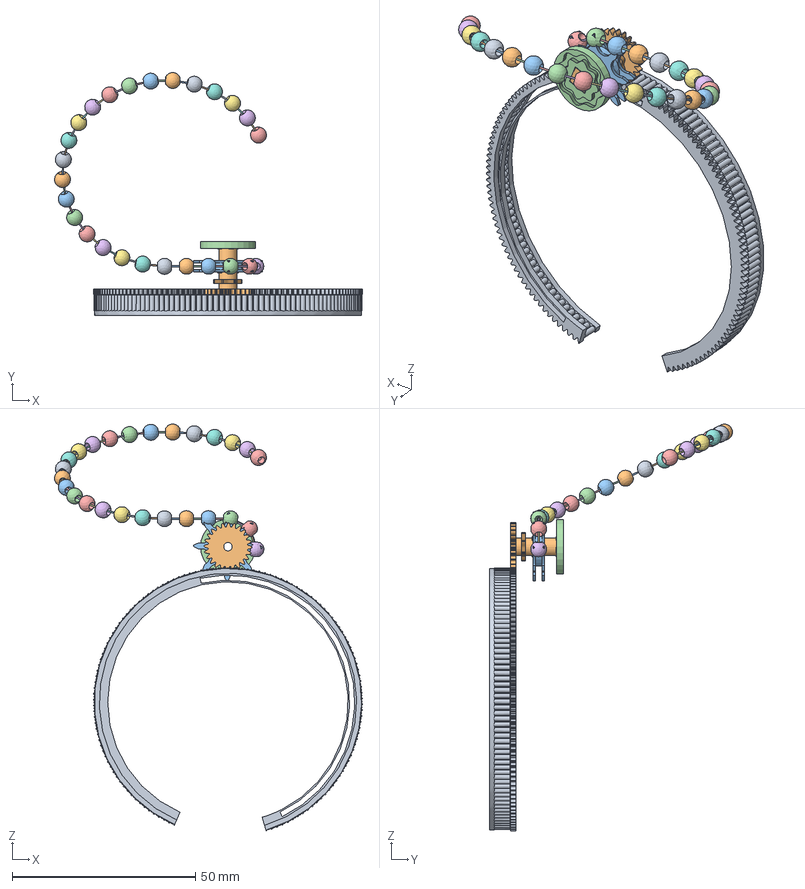
[picture p27: CAD file, 2026-10-27, an earlier design]
cad/v2/Ribosome.FCStd
84.0 x 66.2 x 111.0 mm
128 RNA bases + concealed 144-pitch gear rail
24-tooth RNA pinion + keyed drive shaft
8-pocket forked bead feeder — wire-clear mid-plane
8-cycle closed-groove swivel cam
Amino-acid bead 01 — plain Ø4.4 mm
Amino-acid bead 02 — plain Ø4.4 mm
Amino-acid bead 03 — plain Ø4.4 mm
Amino-acid bead 04 — plain Ø4.4 mm
Amino-acid bead 05 — plain Ø4.4 mm
Amino-acid bead 06 — plain Ø4.4 mm
Amino-acid bead 07 — plain Ø4.4 mm
Amino-acid bead 08 — plain Ø4.4 mm
Amino-acid bead 09 — plain Ø4.4 mm
Amino-acid bead 10 — plain Ø4.4 mm
Amino-acid bead 11 — plain Ø4.4 mm
Amino-acid bead 12 — plain Ø4.4 mm
Amino-acid bead 13 — plain Ø4.4 mm
Amino-acid bead 14 — plain Ø4.4 mm
Amino-acid bead 15 — plain Ø4.4 mm
Amino-acid bead 16 — plain Ø4.4 mm
Amino-acid bead 17 — plain Ø4.4 mm
Amino-acid bead 18 — plain Ø4.4 mm
Amino-acid bead 19 — plain Ø4.4 mm
Amino-acid bead 20 — plain Ø4.4 mm
Amino-acid bead 21 — plain Ø4.4 mm
Amino-acid bead 22 — plain Ø4.4 mm
Amino-acid bead 23 — plain Ø4.4 mm
Amino-acid bead 24 — plain Ø4.4 mm
Amino-acid bead 25 — plain Ø4.4 mm
Amino-acid bead 26 — plain Ø4.4 mm
Copper-core segment (nominal Ø0.36 mm)
Copper-core segment (nominal Ø0.36 mm)001
Copper-core segment (nominal Ø0.36 mm)002
Copper-core segment (nominal Ø0.36 mm)003
Copper-core segment (nominal Ø0.36 mm)004
Copper-core segment (nominal Ø0.36 mm)005
Copper-core segment (nominal Ø0.36 mm)006
Copper-core segment (nominal Ø0.36 mm)007
Copper-core segment (nominal Ø0.36 mm)008
Copper-core segment (nominal Ø0.36 mm)009
Copper-core segment (nominal Ø0.36 mm)010
Copper-core segment (nominal Ø0.36 mm)011
Copper-core segment (nominal Ø0.36 mm)012
Copper-core segment (nominal Ø0.36 mm)013
Copper-core segment (nominal Ø0.36 mm)014
Copper-core segment (nominal Ø0.36 mm)015
Copper-core segment (nominal Ø0.36 mm)016
Copper-core segment (nominal Ø0.36 mm)017
Copper-core segment (nominal Ø0.36 mm)018
Copper-core segment (nominal Ø0.36 mm)019
Copper-core segment (nominal Ø0.36 mm)020
Copper-core segment (nominal Ø0.36 mm)021
Copper-core segment (nominal Ø0.36 mm)022
Copper-core segment (nominal Ø0.36 mm)023
Copper-core segment (nominal Ø0.36 mm)024
