ostrzak/mrna-toy/cad/v4/RibosomeV4.FCStd

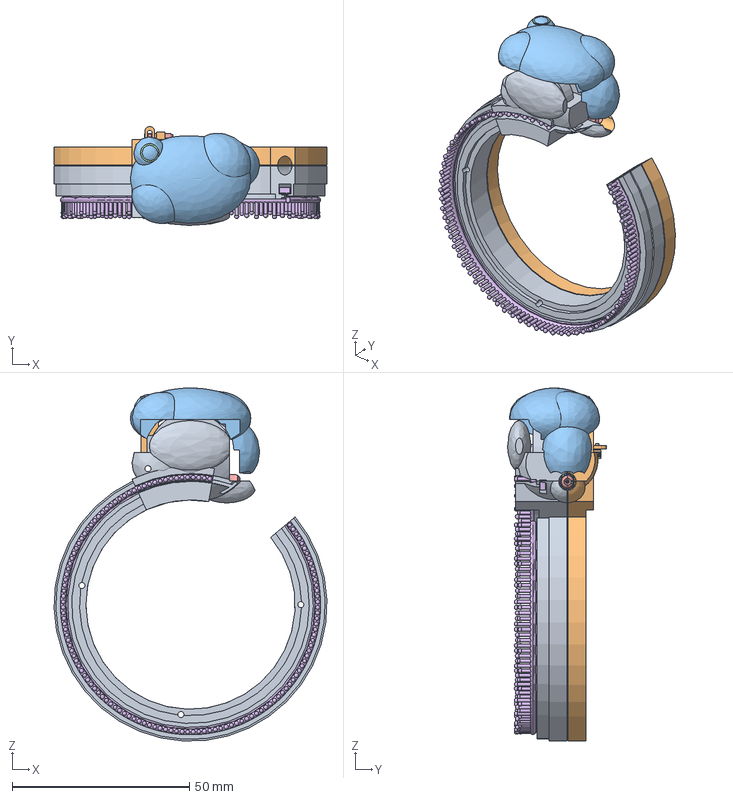
[picture p29: CAD file, 2026-10-30, an earlier design]
cad/v4/RibosomeV4.FCStd
77.0 x 27.9 x 99.5 mm
Recessed RNA-side cuff + fixed organic mechanism cover
Rear cuff half + keeper lid — remove to load
Replaceable click flexure — unloaded, intentional cam preload
Common stationary Ø2 mm axle
Captured cam pin + guided slider + lever pin
RNA strand — 128 projecting bases + concealed drive rail
24-tooth RNA pinion + keyed drive shaft
8-pocket forked bead feeder — wire-clear mid-plane
8-cycle closed-groove swivel cam
Radial slotted lever + vertical swivel post + square key
Organic upper lobe — swivels about outward wrist axis
Swivel-post retaining screw envelope
Amino-acid bead 01 — bilobed, Ø4.4 mm envelope
Amino-acid bead 02 — offset, Ø4.4 mm envelope
Amino-acid bead 03 — trilobed, Ø4.4 mm envelope
Amino-acid bead 04 — offset, Ø4.4 mm envelope
Amino-acid bead 05 — bilobed, Ø4.4 mm envelope
Amino-acid bead 06 — trilobed, Ø4.4 mm envelope
Amino-acid bead 07 — trilobed, Ø4.4 mm envelope
Amino-acid bead 08 — bilobed, Ø4.4 mm envelope
Amino-acid bead 09 — offset, Ø4.4 mm envelope
Amino-acid bead 10 — trilobed, Ø4.4 mm envelope
Amino-acid bead 11 — offset, Ø4.4 mm envelope
Amino-acid bead 12 — bilobed, Ø4.4 mm envelope
Amino-acid bead 13 — trilobed, Ø4.4 mm envelope
Amino-acid bead 14 — trilobed, Ø4.4 mm envelope
Amino-acid bead 15 — bilobed, Ø4.4 mm envelope
Amino-acid bead 16 — offset, Ø4.4 mm envelope
Amino-acid bead 17 — trilobed, Ø4.4 mm envelope
Amino-acid bead 18 — offset, Ø4.4 mm envelope
Amino-acid bead 19 — bilobed, Ø4.4 mm envelope
Amino-acid bead 20 — trilobed, Ø4.4 mm envelope
Amino-acid bead 21 — trilobed, Ø4.4 mm envelope
Amino-acid bead 22 — bilobed, Ø4.4 mm envelope
Amino-acid bead 23 — offset, Ø4.4 mm envelope
Amino-acid bead 24 — trilobed, Ø4.4 mm envelope
Amino-acid bead 25 — offset, Ø4.4 mm envelope
Amino-acid bead 26 — bilobed, Ø4.4 mm envelope
Copper-core segment (nominal Ø0.36 mm)
Copper-core segment (nominal Ø0.36 mm)001
Copper-core segment (nominal Ø0.36 mm)002
Copper-core segment (nominal Ø0.36 mm)003
Copper-core segment (nominal Ø0.36 mm)004
Copper-core segment (nominal Ø0.36 mm)005
Copper-core segment (nominal Ø0.36 mm)006
Copper-core segment (nominal Ø0.36 mm)007
Copper-core segment (nominal Ø0.36 mm)008
Copper-core segment (nominal Ø0.36 mm)009
Copper-core segment (nominal Ø0.36 mm)010
Copper-core segment (nominal Ø0.36 mm)011
Copper-core segment (nominal Ø0.36 mm)012
Copper-core segment (nominal Ø0.36 mm)013
Copper-core segment (nominal Ø0.36 mm)014
Copper-core segment (nominal Ø0.36 mm)015
Copper-core segment (nominal Ø0.36 mm)016
Copper-core segment (nominal Ø0.36 mm)017
Copper-core segment (nominal Ø0.36 mm)018
Copper-core segment (nominal Ø0.36 mm)019
Copper-core segment (nominal Ø0.36 mm)020
Copper-core segment (nominal Ø0.36 mm)021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
