ostrzak/mrna-toy/cad/v5/RibosomeV5.FCStd

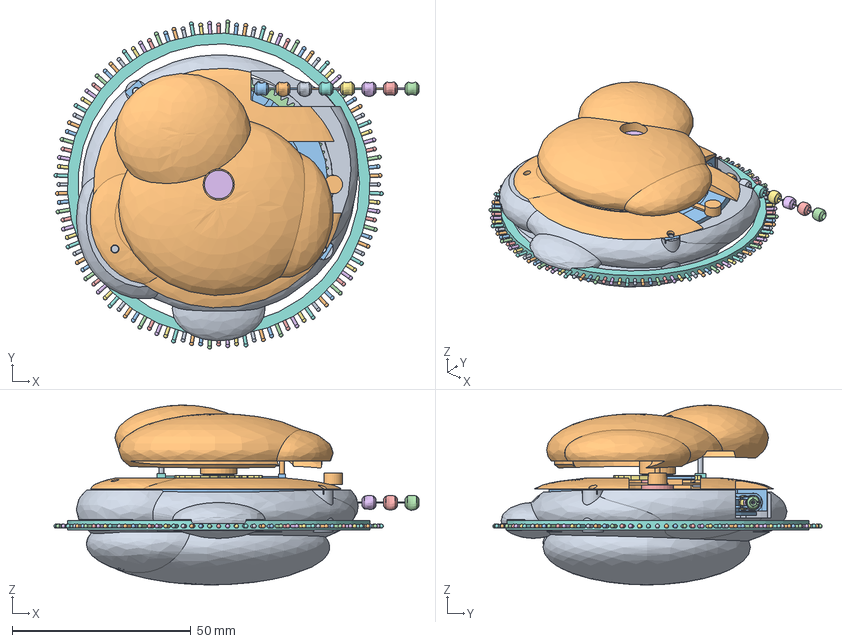
[picture p30: CAD file, 2026-11-02, an earlier design]
cad/v5/RibosomeV5.FCStd
102.0 x 92.0 x 50.2 mm
Larger lower shell — shallow protein cleft
Removable fixed lower-subunit lid
Fixed outer keeper + transfer roof
Closed arcuate travel slot — limits both ends
Stationary Ø6 mm centre axle with retaining-screw pilot
Recessed M2 screw/washer envelope retaining upper rocker
Stationary Ø2 mm idler axle
Holding leaf — unloaded flexure/preload study
Axial release guide for holding leaf
Lift-to-release yoke — clears both ratchet leaves
28-pocket direct storage drum — relieved tangent transfer
84-tooth common-shaft sun gear
Rigid shared drive sleeve — nominal clearance on fixed axle
Ø1.5 mm moving travel-stop pin
28-tooth upper click ratchet
Closed flexible RNA backbone and internal drive teeth
RNA base 001 — free end
RNA base 002 — free end
RNA base 003 — free end
RNA base 004 — free end
RNA base 005 — free end
RNA base 006 — free end
RNA base 007 — free end
RNA base 008 — free end
RNA base 009 — free end
RNA base 010 — free end
RNA base 011 — free end
RNA base 012 — free end
RNA base 013 — free end
RNA base 014 — free end
RNA base 015 — free end
RNA base 016 — free end
RNA base 017 — free end
RNA base 018 — free end
RNA base 019 — free end
RNA base 020 — free end
RNA base 021 — free end
RNA base 022 — free end
RNA base 023 — free end
RNA base 024 — free end
RNA base 025 — free end
RNA base 026 — free end
RNA base 027 — free end
RNA base 028 — free end
RNA base 029 — free end
RNA base 030 — free end
RNA base 031 — free end
RNA base 032 — free end
RNA base 033 — free end
RNA base 034 — free end
RNA base 035 — free end
RNA base 036 — free end
RNA base 037 — free end
RNA base 038 — free end
RNA base 039 — free end
RNA base 040 — free end
RNA base 041 — free end
RNA base 042 — free end
RNA base 043 — free end
RNA base 044 — free end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
