ostrzak/mrna-toy/cad/v6/RibosomeV6.FCStd

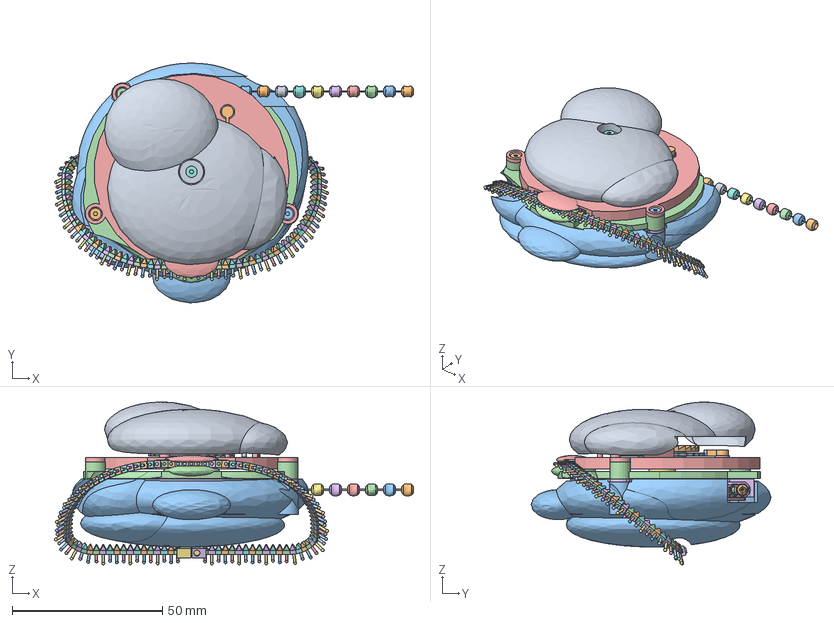
[picture p31: CAD file, 2026-11-02, an earlier design]
cad/v6/RibosomeV6.FCStd
119.6 x 79.9 x 54.3 mm
Symmetric click follower — nominal flexed pose
Prescribed flexible leaf chord — force/fatigue unqualified
Prescribed flexible leaf chord — force/fatigue unqualified001
Prescribed flexible leaf chord — force/fatigue unqualified002
Prescribed flexible leaf chord — force/fatigue unqualified003
Prescribed flexible leaf chord — force/fatigue unqualified004
Prescribed flexible leaf chord — force/fatigue unqualified005
Prescribed flexible leaf chord — force/fatigue unqualified006
Prescribed flexible leaf chord — force/fatigue unqualified007
Integral click-leaf root — joined to fixed cover pedestal
Flattened palm dome — shallow open RNA return groove
Lower shell lid and gear-cover mounts
Covered drive, short central RNA throat and fixed lift cam
Fixed bead keeper and tangent transfer roof
Integral lower-body spindle with flared root and fixed washer shoulder
M2 x 4 cap screw — nominal thread envelope and hex socket
Cap retaining washer — seated on fixed spindle, 0.15 mm rocker endplay
M2 x 12 countersunk housing screw — nominal thread envelope
M2 x 12 countersunk housing screw — nominal thread envelope001
M2 x 12 countersunk housing screw — nominal thread envelope002
Direct 28-pocket storage drum — tangent-relieved forks
84-tooth RNA rack gear — three bases per bead
Lower rotor D-key spindle and thrust flange — lid installs before upper rotor
Concentric input carrier outside the cap bearing
28 symmetric rounded click notches — reversible
Upper-input-only drive faces — idle input lifts clear
Positive shared drum travel-stop pin
TPU backbone cell 002 + drive tooth
Free-ended RNA base 002
TPU backbone cell 003 + drive tooth
Free-ended RNA base 003
TPU backbone cell 004 + drive tooth
Free-ended RNA base 004
TPU backbone cell 005 + drive tooth
Free-ended RNA base 005
TPU backbone cell 006 + drive tooth
Free-ended RNA base 006
TPU backbone cell 007 + drive tooth
Free-ended RNA base 007
TPU backbone cell 008 + drive tooth
Free-ended RNA base 008
TPU backbone cell 009 + drive tooth
Free-ended RNA base 009
TPU backbone cell 010 + drive tooth
Free-ended RNA base 010
TPU backbone cell 011 + drive tooth
Free-ended RNA base 011
TPU backbone cell 012 + drive tooth
Free-ended RNA base 012
TPU backbone cell 013 + drive tooth
Free-ended RNA base 013
TPU backbone cell 014 + drive tooth
Free-ended RNA base 014
TPU backbone cell 015 + drive tooth
Free-ended RNA base 015
TPU backbone cell 016 + drive tooth
Free-ended RNA base 016
TPU backbone cell 017 + drive tooth
Free-ended RNA base 017
TPU backbone cell 018 + drive tooth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
