ostrzak/mrna-toy/cad/v6-updated-print/mechanism.png

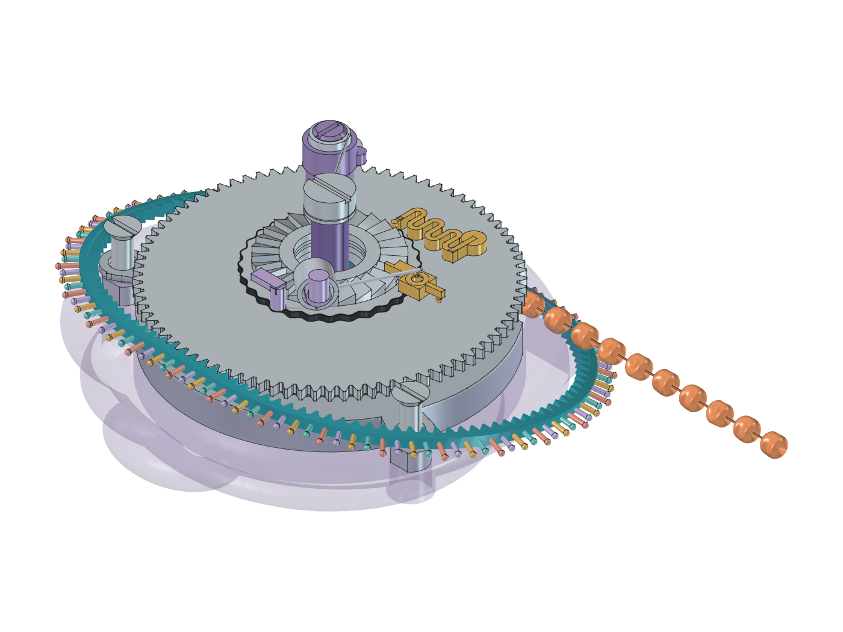
cad/v6-updated-print/mechanism.png
