ostrzak/mrna-toy/cad/v6-updated-print/printed-fasteners.png

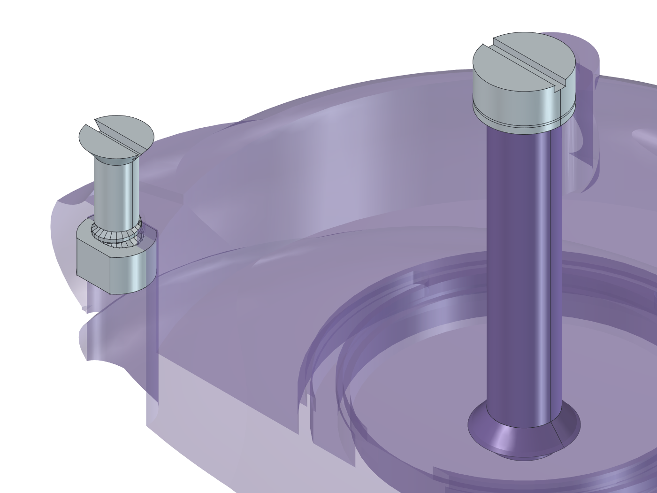
cad/v6-updated-print/printed-fasteners.png
