ostrzak/mrna-toy/cad/v6-updated-print/spring-installation.png

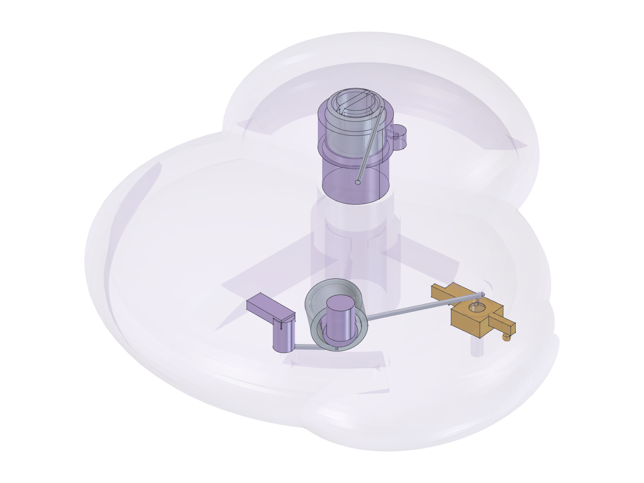
cad/v6-updated-print/spring-installation.png
