ostrzak/mrna-toy/cad/v6-updated-print/spring-loaded.png

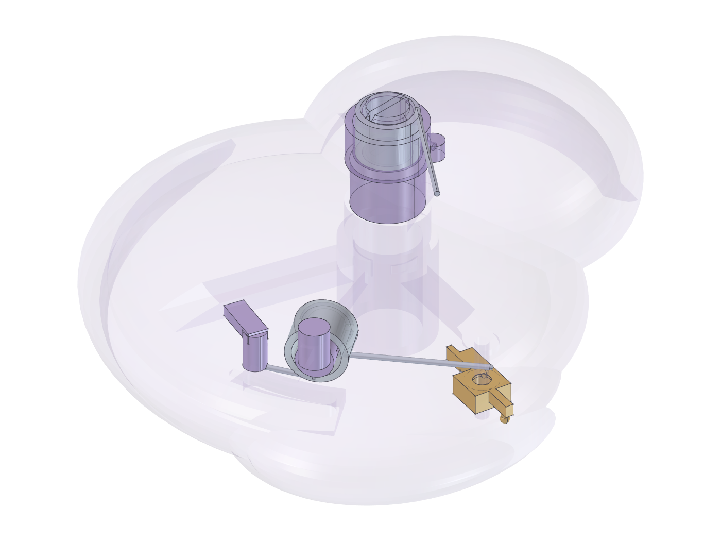
cad/v6-updated-print/spring-loaded.png
