ostrzak/mrna-toy/cad/v6-updated-print/stock-springs.png

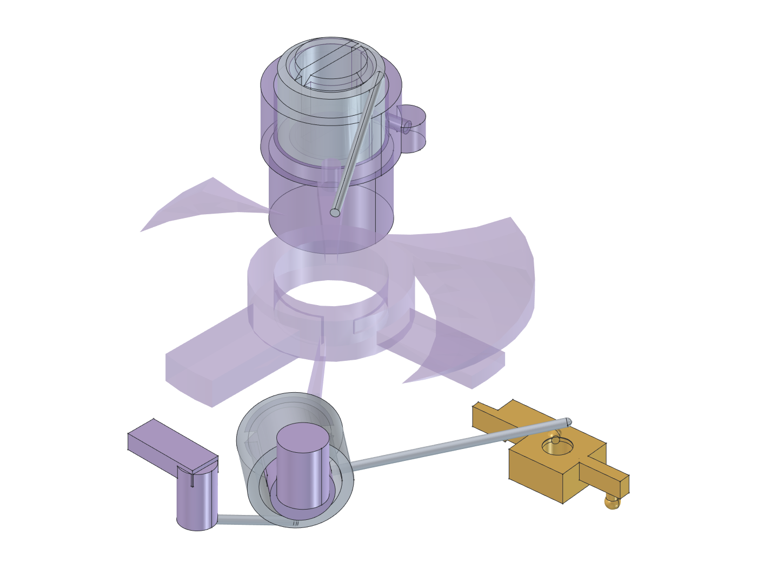
cad/v6-updated-print/stock-springs.png
