ostrzak/mrna-toy/cad/v6-updated/spring-installation.png

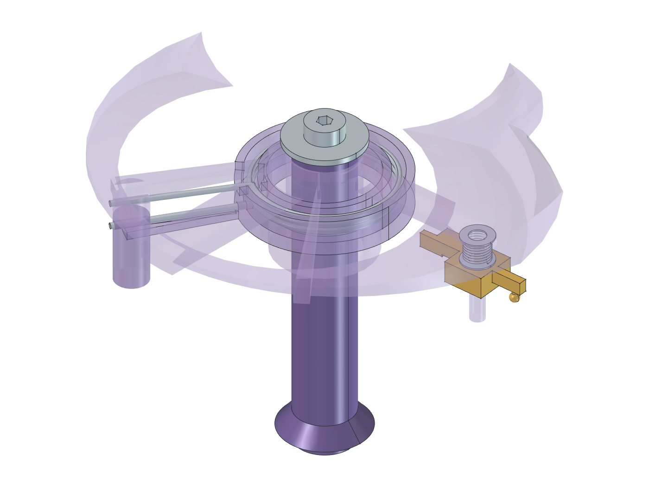
cad/v6-updated/spring-installation.png
