ostrzak/mrna-toy/(commit log)

2026-10-27 Initial commit: mRNA toy CAD models, source, and concepts
    [Ribosome.FCStd, RibosomeV3.FCStd]
2026-10-30 Add V5 handheld ribosome and preserve V4 print prototype
    [00-TPU-bore-tests.3mf, 01-PETG-fits-and-feeder-test.3mf, 10-PETG-cuff-front.3mf, 11-PETG-cuff-rear.3mf, 12-PETG-RNA.3mf, 13-PLA-mechanism.3mf, 14-PLA-chain-pitch-jig.3mf, 15-TPU-production-beads.3mf]
2026-11-02 Add V6 captive RNA fidget, assembly refinements and inspection views
    [RibosomeV5.FCStd, RibosomeV6.FCStd]
2026-11-02 Save incomplete V7 candidate and cloud continuation handoff
    [RibosomeV7.FCStd]
2026-11-03 Checkpoint incomplete V7 cloud continuation and matched CAD evidence
    [RibosomeV7.FCStd]
2026-11-03 Record completed V7 CAD audit and remaining mechanical failures
2026-11-03 Checkpoint V7 rigid repairs and unfinished mechanical validation
    [RibosomeV7.FCStd]
2026-11-03 Add V6 updated routing and explicit spring candidate
    [RibosomeV6Updated.FCStd]
2026-11-05 Review V6 updated export feasibility and print hardware
2026-11-11 Checkpoint V6 updated print candidate and package removals
    Save the separate printed-fastener and stock-spring CAD candidate, matched evidence, inspection images, documentation, and export helpers. Keep mechanical and physical qualification at REVIEW.
    Include the existing removal of the V4 A1 mini print package. Repository validation currently fails because print handoff files and linked V4/V6 print guides are missing.
    [00-TPU-bore-tests.3mf, 01-PETG-fits-and-feeder-test.3mf, 10-PETG-cuff-front.3mf, 11-PETG-cuff-rear.3mf, 12-PETG-RNA.3mf, 13-PLA-mechanism.3mf, 14-PLA-chain-pitch-jig.3mf, 15-TPU-production-beads.3mf]
2026-11-11 Publish V6 prototype package and physical preparation handoff
    Add the 33.18 MB prototype ZIP with matched CAD, 20 grouped STEP/STL exports and the sliced nine-piece PETG fit plate. Publish the BOM and fit-test guide, and document explicit version6-updated checkout for cloud continuation.
    Archive integrity and all 23 packaged CAD files match the saved candidate. Physical qualification remains REVIEW. Repository checks now report only the previously removed V4 print handoff files and their broken links.
2026-11-11 Update cloud handoff for main branch integration
    Document main as the cloud continuation branch while retaining version6-updated. CAD and manufacturing qualification boundaries are unchanged. Repository checks still report the previously deleted V4 print handoff files and links.
